neuralbertatech/natKit-IMU/(commit log)

2023-08-20 add new IMU library
2023-08-21 get new IMU working
2025-03-16 Starting point for board
    [Board.kicad_pcb, Board.kicad_sch, board.kicad_pcb, board.kicad_sch]
2026-04-09 Updated sample config
2026-07-27 IMU: frame envelope + heartbeat + reliable MQTT; restore real-sensor flow
    - NatImuBulkDataSchema carries a 24B binary frame header (schemaVersion,
    sampleCount, sampleRateHz, seqNo, deviceTsUs), populated per bulk; adds a
    ~1 Hz device.firmware.status.v1 heartbeat on a Heartbeat topic.
    - Restore real BNO08x streaming (regression fix): pin all lib_deps; the culprit
    was unpinned Adafruit BusIO floating to 1.17.3/1.17.4, whose SPIDevice rewrite
    crashed begin_SPI(). Pinned BusIO@1.17.2 + froze the tree.
    - Add -frtti (unflag -fno-rtti): the pinned libnatkit-core *Descriptor classes
    use dynamic_cast, which the espressif32 Arduino framework rejects by default.
    - MQTT robustness: KafkaTopic: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
    [kafkaTopic.hpp, main.cpp]
2026-07-27 IMU: disable status NeoPixels (RMT driver crash reboots the device)
    Adafruit_NeoPixel::show() re-installs the ESP32 RMT driver on every call and
    leaks channels; after ~11 calls rmt_driver_install asserts (xQueueGenericSend
    null queue) and the device reboots in a ~14 s loop. The cosmetic calibration /
    source-indicator LEDs are not worth crashing the stream, so gate them behind
    IMU_STATUS_LED_ENABLED (default 0). Re-enable in a later cleanup pass with the
    RMT driver installed once instead of per show().
    [ImuReader.hpp]
2026-07-27 IMU: fix heap leak that crashed the device with std::bad_alloc
    The intermittent reboot was an uncaught std::bad_alloc in NatImuBulkDataSchema::
    encodeToBytes when the heap ran out. Root cause: nat::core::Optional<T> (used by
    SensorDataPoint::dataMaybe) heap-allocates its value (new T) on every copy, and a
    SensorDataPoint is copied many times per IMU sample as it flows through the
    buffers — leaking/churning ~3 KB per bulk until allocation failed.
    Fix: store the value INLINE.
    - Add InlineOptional<T> (no heap, no C++17 dep — the Arduino build is gnu++11)
    as a drop-in for the .value()/.has_value()/`= T{}` subset used, and use it for
    SensorDataPoint::dataMaybe instead of nat::core::Optio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
    [SensorBuffer.hpp]
2026-07-27 IMU: use nat::core::Optional (now inline) for dataMaybe; drop InlineOptional
    libnatkit-core's Optional<T> now stores its value inline (no heap), so the
    firmware-local InlineOptional stopgap is no longer needed. SensorDataPoint::
    dataMaybe goes back to nat::core::Optional<T> and InlineOptional is deleted.
    Verified on hardware: 0 aborts over 60 s, ~2.4 sends/s, heap stable (the CircularBuffer
    512->32 right-size stays).
    Requires the matching libnatkit-core Optional change (inline storage).
    [SensorBuffer.hpp]
2026-07-27 IMU: bump libnatkit-core pin to 5f1e965 (inline Optional)
    a039fd0 -> 5f1e965: picks up the inline-storage Optional<T> (no per-copy heap
    alloc). Verified with a clean re-fetch + build + flash: 0 aborts, ~2.3 sends/s.
2026-07-27 IMU: drop dead deps — SensorLab (+~24-lib subtree), MQTT.h, ArduinoJson
    - Adafruit_SensorLab: unused member (never called) + include removed; dropping it
    from lib_deps drops its huge transitive Adafruit subtree. NeoPixel was pulled
    transitively by it and IS referenced (status LED, currently gated off), so it's
    now an explicit pinned dep.
    - 256dpi/MQTT (<MQTT.h>): unused (code uses PubSubClient); include + dep removed.
    - ArduinoJson: only-commented usages; dep removed.
    Flash 89.6% -> 88.6%. Verified on hardware: 0 aborts, ~2.1 sends/s.
2026-07-27 IMU: retry MQTT bring-up instead of stranding if broker is down at boot
    Previously, if MQTT couldn't connect within MQTT_MAX_CONNECT_RETRIES at boot, the
    firmware went to a dead Disconnected state and sat there until a manual reset. Now
    it backs off and re-enters the WiFi+MQTT bring-up from the top and keeps retrying
    (nothing is allocated before a successful connect, so retrying forever is safe).
    Verified on hardware: with the broker stopped the device loops connect→backoff→
    retry (no stranding); when the broker returns it reconnects and streams on its own
    with no reset (meta written, ~2.4 sends/s, 0 reboots).
    [main.cpp]
2026-07-27 IMU: drop -frtti; bump libnatkit-core pin to c1f0868 (getName dispatch)
    libnatkit-core no longer uses dynamic_cast (c1f0868 replaced it with getName()
    dispatch), so the firmware compiles with the Arduino framework's default
    -fno-rtti again. Removed the -frtti build_flag and the -fno-rtti build_unflag.
    Flash 88.6% -> 87.7%. Verified: builds + runs (0 aborts, streaming).
    Requires libnatkit-core c1f0868 to be pushed (pin points at it).
2026-07-27 IMU: fix warnings surfaced by the ESP-IDF build attempt (Phase 2a groundwork)
    The stricter ESP-IDF (arduino+espidf) build exposed real issues, fixed here (all
    valid under the current Arduino build too):
    - ImuReader start2(): printf("%s", std::string) -> .c_str() (was UB / would crash
    on the sensor-start error path).
    - ImuReader update_loop() debug stats: printf("%d", uint64_t) -> "%llu" + casts.
    - Bno08xDevice2: stray trailing '\' turned a // comment into a multi-line comment.
    - kafkaTopic ctor: member-init order now matches declaration order (metaStream
    before bulkDataStream) — was a -Wreorder.
    platformio.ini keeps framework=arduino; the arduino,espidf line is annotated with
    the rema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
    [Bno08xDevice2.hpp, ImuReader.hpp, kafkaTopic.hpp]
2026-07-27 IMU: remove vendored components/ (stock ESP-IDF 5.x copies, unused, blocked IDF build)
    components/esp_eth, esp_netif, esp_netif_stack were verbatim upstream ESP-IDF 5.x
    component copies (full with test_apps/, Kconfig, linker.lf) — not natKit code and
    not referenced anywhere. Under pure-Arduino they were ignored; under the ESP-IDF
    build they're processed as components and broke it (esp_eth REQUIRES esp_driver_spi,
    a 5.x-only component absent from the bundled 4.4.7). The IMU uses WiFi (framework's
    esp_netif), not Ethernet. Removing them clears the first Phase-2a (arduino,espidf)
    blocker; Arduino build unaffected.
2026-07-27 WIP Phase 2: ESP-IDF 5.x re-baseline via pioarduino (COMPILES; boot-blocked)
    Platform espressif32@6 (arduino 2.0.17 / IDF 4.4.7) -> pioarduino 55.03.311
    (arduino-esp32 3.3.11 / ESP-IDF 5.5.5, matches natVR). Builds clean after:
    - WiFiEvent(): SYSTEM_EVENT_* -> ARDUINO_EVENT_WIFI_* (arduino 3.x enum), simplified
    to the functional STA cases.
    - esp_task_wdt_init(timeout,panic) -> IDF 5.x config-struct + esp_task_wdt_reconfigure.
    - #include <esp_mac.h> for esp_efuse_mac_get_default (moved in IDF 5.x).
    - board_build.partitions = huge_app.csv (arduino 3.x overflows the default ~1.3MB app).
    - removed stale sdkconfig.release (was IDF 5.1.1).
    BLOCKED at boot: "esp_timer: Not enough memory to creat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
2026-07-27 Phase 2: ESP-IDF 5.x re-baseline BOOTS + streams on hardware
    pioarduino / arduino-esp32 3.3.11 / ESP-IDF 5.5.5 (matches natVR). Verified on the
    ESP32-PICO-D4: boots clean, BNO08x inits, WiFi + NTP + MQTT all up, streaming
    NatImuBulkDataSchema frames at ~2.5/s with zero crashes over 45s.
    Two boot-blockers fixed via `custom_sdkconfig` (triggers pioarduino's from-source
    Arduino/IDF HybridCompile instead of the PSRAM-board prebuilt libs):
    - CONFIG_SPIRAM=n / CONFIG_BT_ENABLED=n: the prebuilt esp32 libs assume a PSRAM
    board (SPIRAM=y, RESERVE_INTERNAL=0) and enable full BTDM (~64KB DRAM). The
    PICO-D4 has neither PSRAM nor a BT use, so the internal heap was starved and
    esp_timer couldn't cr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
    [huge_app.csv]
2026-07-27 IMU: gitignore pioarduino HybridCompile artifacts; drop stale espidf-experiment files
    custom_sdkconfig makes pioarduino build Arduino/IDF from source, which generates
    .dummy/, managed_components/ (dozens of IDF components), and sdkconfig.defaults/
    release in the project dir on every build — now gitignored. Also drop the leftover
    CMakeLists.txt / dependencies.lock / sdkconfig.debug from the abandoned Phase 2a
    combined-mode experiment (the build regenerates/removes them; a fresh CMakeLists
    will be written if/when subsystems go native ESP-IDF).
2026-07-27 IMU: natVR-style small frames for a smooth live stream (10 samples/frame)
    The stream was choppy/laggy in the viewer because the firmware batched a full
    IMU_POLLING_HZ (100) samples into one ~5 KB frame and only flushed it once full —
    ~2.6 frames/s, a big burst every ~380 ms. natVR stays smooth by flushing a small
    fixed frame the instant it fills (50 samples → ~20 fps) and draining it with a
    notify-driven publish. The IMU already had the notify-driven send; it just batched
    too much.
    Decouple the two meanings IMU_POLLING_HZ was overloading:
    - IMU_SAMPLES_PER_FRAME = 10 — the wire frame batch size (was 100). The BNO08x
    merged accel/gyro/rotation stream runs ~120-250 Hz, so 10 samples/f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
    [kafkaTopic.hpp]
2026-08-04 BNO08x: stop the boot crash loop (null write in sh2 sensor callback)
    Adafruit_BNO08x keeps a file-static sh2_SensorValue_t* that its SH2
    sensor callback writes through, and it is NULL until the first
    getSensorEvent() assigns it. Every sh2 op pumps SHTP while awaiting its
    reply, so once one report was enabled a queued sensor event was delivered
    mid-op and the callback wrote through NULL -- StoreProhibited at address
    0 inside sh2_decodeSensorEvent, on every boot.
    Prime the static with the long-lived member before enabling any report,
    configure calibration while the chip is still silent, and zero-init
    sensorValue (getSensorEvent decides "no new event" partly from sensorId,
    so garbage could fak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
    [Bno08xDevice2.hpp]
2026-08-05 Phase 1 cleanup: centralise config, delete dead code, fix stale comments
    Behaviour-preserving pass from the overhaul plan, after the fix-first work.
    - BoardConfig.hpp is now the one place for pins, the sample interval and the
    MQTT port. The BNO08x SPI pins were previously defined IDENTICALLY in both
    Bno08xDevice2.hpp and ImuReader.hpp: an identical macro redefinition is
    legal, which is exactly what made it dangerous -- edit one copy and the
    build stays silent while half the firmware talks to different pins. The
    hardcoded 1883 in main.cpp becomes NATKIT_MQTT_PORT.
    - Deleted 690 lines of commented-out code: the Kafka-REST/HTTP legacy in
    kafkaTopic.hpp (617 -> 315 lines) and old sa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
    [Bno08xDevice2.hpp, BoardConfig.hpp, ImuReader.hpp, kafkaTopic.hpp, main.cpp]
2026-08-05 BNO08x: stop sh2_setCalConfig failing silently, and log what the hub says
    Measured on hardware while investigating a report that calibration got worse:
    sh2_setCalConfig(0x07) FAILED with -5 (SH2_ERR_HUB)
    dynamic calibration enabled = 0x05 (accel=1 gyro=0 mag=1)
    Two separate findings.
    1. The call only succeeds as the FIRST hub command after begin_SPI. Asked any
    later -- after the priming getSensorEvent(), or after the enableReport calls --
    the hub rejects it. It has sat after the reports since Feb 2026 (71e3be8) with
    its return value discarded, so it had been failing silently that whole time.
    Moved to the front, where it succeeds.
    2. Even when it succeeds the hub repo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
    [Bno08xDevice2.hpp]
2026-08-05 BNO08x: record what the calibration probe established
    Removes the temporary probe loop and keeps its finding in a comment:
    sh2_getCalConfig is not a faithful read-back on this hub. Probed as the first
    hub command, every mask (0x01, 0x02, 0x04, 0x03, 0x05, 0x07, 0x0f) was accepted
    with a return of 0, while the read-back stayed 0x05 in every case -- including
    when only SH2_CAL_ACCEL was set.
    So the logged value reports what the hub says, not what is in effect, and it
    cannot be used to confirm gyro dynamic calibration is enabled. This also
    retracts the earlier note claiming the hub "drops SH2_CAL_GYRO": the read-back
    simply does not track the setting.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
2026-08-05 BNO08x: keep the streaming order; log the calibration probe findings
    Investigating a report that calibration quality regressed. Findings, all measured
    on hardware:
    - sh2_setCalConfig returns SH2_ERR_HUB (-5) where it sits, and has done since
    Feb 2026 (71e3be8) with its return value discarded, so it failed silently that
    whole time. That predates nothing: it was ADDED in Feb, so a year ago it was
    not called at all and the chip ran on its defaults -- as it still does.
    - Making it the first hub command DOES make it succeed. Do not do that: the
    BNO08x then stops producing sensor reports entirely ("Nothing to read" x120,
    zero frames published). Reverted to the ordering verified streamin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
    [Bno08xDevice2.hpp]
2026-08-05 Firmware: EXECUTION_COMMAND channel (server -> sensor) with output on LOGGING_LOG
    The device now subscribes to its own command topic and executes what the server
    sends, reporting the result on its log topic correlated by command_id:
    Kafka Command-<id>-Json-NatExecutionCommandV1
    -> bridge -> MQTT natKit/receiving/<topic> -> device
    -> MQTT natKit/sending/Log-<id>-Json-NatLogV1 -> bridge -> Kafka
    Commands: ping, calibrate.save_dcd, calibrate.status. "target" addresses either
    "sensor" (or this device's id) or "server", so the same topic can carry traffic
    in both directions; anything aimed elsewhere is ignored.
    PubSubClient is single-writer and the SH2 hub belongs to the IMU task, so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
2026-08-05 Firmware: actually enable gyro dynamic calibration (fixes rotation stuck at Unreliable)
    The BNO085's rotation accuracy has been pinned at Unreliable because gyro dynamic
    calibration was never on. sh2_setCalConfig has returned SH2_ERR_HUB from setup()
    since Feb 2026 (71e3be8, where its return value was discarded), leaving the hub
    on its documented default 0x05 = accel|mag. Gyro accuracy therefore sat at 0
    forever, and no amount of careful hand-calibration could move the rotation
    vector. That is the whole bug.
    The call cannot be made to work anywhere in setup(). Measured, on hardware:
    as the first hub command -> SH2_OK, but the hub then emits no reports at all.
    before the enableReports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
    [Bno08xDevice2.hpp, CommandChannel.hpp, ImuReader.hpp, main.cpp]
2026-08-05 Firmware: mask the SH2 status byte before treating it as an accuracy
    sensorValue.status is not an accuracy: bits 1:0 are the accuracy (0 = Unreliable
    .. 3 = High) and bits 7:2 carry the report delay. All eight read sites used it
    raw, and the values are later packed two bits per sensor -- so any report with a
    nonzero delay both misreported its own sensor and spilled into the neighbouring
    sensors' fields. Masked at the source, plus a packAccuracy() guard at the packing
    site so an out-of-range value can never corrupt a neighbour again.
    Latent until now (the delay bits have been zero in every frame measured), but it
    sits directly under the calibration readout, which is the thing being trusted.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
2026-08-06 Updateds to try to fix calibration issues
    [Bno08xDevice2.hpp, ImuReader.hpp, main.cpp]
2026-08-10 Scaffold the native ESP-IDF fork beside the current firmware (TEC-NATKIT-21)
    Slice 0 of the primary/secondary architecture epic (TEC-NATKIT-20): stand up
    the fork, decide where it lives, and write down the rollback contract before
    any behaviour is ported, so nothing later has to be untangled from the working
    image.
    firmware-idf/ is a sibling of embeded/, native idf.py, modelled on
    natVR/firmware. Nothing here edits embeded/, which stays the image on the
    bench; the two trees share no toolchain, no build directory and no config.
    The role (leaf / primary / gateway) is a Kconfig choice rather than a
    hand-edited define, so it is three images from one tree. main.cpp logs the boot
    banner -- firmw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
2026-08-10 Correct the esp32 defaults from what the board actually reports (TEC-NATKIT-21)
    Booting the leaf image on the real node (ESP32-PICO-V3-02, MAC
    0c:8b:95:96:b9:f4) contradicted two comments written from the datasheet:
    - The chip has 8 MB of embedded flash, not 4 MB, so the app warns on every boot
    that the detected size exceeds the image header. Left declared at 4 MB
    deliberately -- under-declaring wastes flash, while an image header claiming
    8 MB on a 4 MB part is the direction that breaks, and the older PICO-D4 in the
    fleet is a 4 MB part. Documented rather than silently "fixed".
    - The V3-02 does have embedded PSRAM. It stays off, but now for the real reason
    (nothing needs it, and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
2026-08-10 READMEs: record the hardware verification and the board's current firmware
    The fork's README claimed the boot was unverified; it is verified now, so say
    what was seen rather than leaving a stale caveat. Also record that the node
    briefly ran the leaf image and was restored, where the pre-flash flash dump
    lives, and the two console gotchas: read the serial port from exactly one
    process (two readers splice lines together and it reads like a firmware bug),
    and idf.py qemu needs a libslirp this box does not have.
2026-08-10 README: document the QEMU boot check, now that it works on this box
    libslirp landed, so idf_tools could install qemu-xtensa and qemu-riscv32, and
    every role can get a boot check with no board attached. All six images have now
    been booted rather than merely built: leaf/esp32 on the real node, and
    primary/esp32, gateway/esp32 and leaf/esp32c3 under QEMU -- the C3 reporting
    "rev 0.3, 1 core(s)" also confirms the packed-revision handling on a second
    target.
    Three caveats recorded, because each would otherwise cost someone an hour: the
    plain `qemu` action works headless while `qemu monitor` refuses without a TTY;
    QEMU's efuse is blank so the MAC and device id read zero and must not be
    "fixed"; a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
2026-08-11 BNO08x on native ESP-IDF: driver, SPI HAL and setup (TEC-NATKIT-22, WIP)
    NOT STREAMING YET. The sensor initialises, talks, and produces real readings,
    but sustained streaming stops after a handful of reports. Committed because the
    transport, the setup sequence and two hardware findings are worth not losing, and
    because the diagnostics below are what any further debugging needs.
    What is in:
    - components/sh2: Hillcrest/CEVA's SH-2 driver lifted verbatim out of the
    Adafruit BNO08x 1.2.5 copy the Arduino firmware links (Apache 2.0, unedited).
    Identical decode is the point -- it is what makes a recording from the fork
    comparable with one from ../embeded, which is what TEC-NATKIT-27 measur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
2026-08-11 ESP-NOW bench probe: the frame fits in one packet (TEC-NATKIT-23)
    The epic sized the on-air frame problem from a "~5 KB frame" against ESP-NOW's
    "250 byte" limit. Both numbers were wrong, and the difference removes the
    fragmentation question entirely.
    Measured, not assumed:
    - The frame is 524 bytes. NatImuBulkDataSchema Binary encodes 24 + 50 *
    sampleCount and the running firmware publishes 10 samples per frame -- the live
    console prints "Bytes Encoded 524". The 5 KB figure looks like the legacy
    5000-byte fallback or the 16 KB MQTT buffer, not what is transmitted.
    - ESP-NOW on this PICO-D4 reports version 2 with a ceiling of exactly 1470 bytes:
    1470 is accepted and confirmed, 1471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
    [espnow_probe.cpp, espnow_probe.hpp, main.cpp]
2026-08-12 Un-gate the ESP-NOW channel so the node roles build again (TEC-NATKIT-23)
    CONFIG_NATKIT_ESPNOW_CHANNEL depended on NATKIT_ESPNOW_PROBE, so the symbol
    disappeared whenever the probe was not selected -- and espnow_probe.cpp, which
    compiles into EVERY image by design, reads it as a value. Leaf, primary and
    gateway therefore all failed with "'CONFIG_NATKIT_ESPNOW_CHANNEL' was not
    declared in this scope" since e7894ca. Only the probe role built.
    The dependency is dropped rather than wrapping the file in #if
    CONFIG_NATKIT_ESPNOW_PROBE, because compiling every source into every image is
    the invariant that stops a role from silently rotting; making the probe
    conditional would exempt it from exactly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
2026-08-12 BNO08x streams on native IDF: drive MOSI, drive CS by hand (TEC-NATKIT-22)
    The port read the hub correctly but could not sustain streaming: a few reports
    arrived, then the hub reset itself ~10 times in 40s and reads returned 15-byte
    SHTP channel-0 packets instead of the channel-3 sensor reports that had been
    enabled. Two differences from ../../embeded's Adafruit stack -- which streams on
    this exact board -- were found by reading it rather than by guessing, and fixing
    both is what makes the difference.
    MOSI was not driven at all. Adafruit_SPIDevice::read() memsets the caller's
    buffer to its sendvalue (0x00 here) and then does a FULL-DUPLEX transfer, so
    MOSI carries zeros for every clock of e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
    [bno08x.cpp, leaf.cpp]
2026-08-12 ESP-NOW loss run: fix the instrument, then measure zero loss (TEC-NATKIT-23)
    The multi-node loss run needed a second board, which arrived. Running it found
    three defects in the probe first, all of which corrupted the very figure the
    receiver exists to produce -- it reported 3051 sequence gaps from 243 packets,
    which would have read as catastrophic loss.
    The sequence is now ONE monotonic counter for the whole probe run, advanced only
    when esp_now_send accepts the frame:
    - measureSendRate used the loop index, so each run restarted at 0 and the runs
    could not be told apart on the receiving side.
    - That index advanced even when esp_now_send REJECTED the frame. Flat out, 340 of
    500 are refus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
    [espnow_probe.cpp]
2026-08-12 Leaf: sensor to ESP-NOW, no WiFi, no MQTT, no NTP, no netif (TEC-NATKIT-24)
    The leaf role is real. It builds the canonical NatImuBulkDataSchema frame on the
    node -- TEC-NATKIT-23's recorded decision -- and unicasts it to a primary it
    discovers, with a bounded queue between the sample loop and the radio.
    new imu_frame.{hpp,cpp}: the canonical frame encoder. This is deliberately a
    SECOND implementation of a wire format that lives in libnatkit-core, because a
    leaf that links a C++ schema library is not the lean node this epic is testing.
    That duplication can drift, so the layout is pinned by static_asserts on every
    size (including that 10 samples encode to exactly 524 bytes), derived from the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
    [espnow_link.cpp, espnow_link.hpp, imu_frame.cpp, imu_frame.hpp, leaf.cpp, primary.cpp]
2026-08-12 Timing broadcast and time-shift proxy: nodes on one clock (TEC-NATKIT-17)
    Leaves have no NTP by design, so their sample timestamps are monotonic since
    their own boot and two nodes' timestamps are not comparable. The primary is now
    the clock master and closes that gap.
    The ticket's first recommended approach does not survive the architecture, and
    this was checked before any code was written: esp_wifi_get_tsf_time() returns 0
    on a station that is not associated, and no node here ever associates. Confirmed
    on hardware, not just cited from the header. Its receive-side counterpart does
    exist -- rx_ctrl->timestamp is a genuine hardware stamp -- but measured against
    esp_timer it scatters by 20-57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
2026-08-12 Node-to-node coherence, measured against a held-out marker (TEC-NATKIT-4)
    #340 measured each leaf against the primary. What a recording with two sensors on
    it actually depends on is whether two LEAVES agree, and that was only inferred --
    from two leaf-to-primary figures plus an argument that their common-mode bias
    cancels. Reasonable, and untested. With a third board it is now measured.
    The primary broadcasts a SyncMarker every fifth beacon. Both leaves receive the
    same wavefront -- they are metres apart, so propagation between them differs by
    nanoseconds -- each converts its own receive time into primary time with its own
    fit, and reports the answer. The difference between the two answers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
2026-08-12 Primary: node registry, framed serial uplink and explicit backpressure (TEC-NATKIT-25)
    Two leaves now stream through one primary to a host reading framed serial, with
    counters that reconcile.
    REASSEMBLY IS OUT, and this is a deletion rather than a deferral. The ticket says
    "rebuilds whole frames IF the frame-format decision puts reassembly here", and
    #346 decided it does not: 524 bytes against a measured 1470-byte ESP-NOW ceiling,
    one frame is one packet. So there is no fragment buffer to time out, and a lost
    packet stays a whole missing frame that seqNo makes detectable.
    The frame carries TWO sequence numbers, which is the point of its header. The
    uplink's own says whether the primary dro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
    [espnow_link.cpp, primary.cpp, read_uplink.py, registry.cpp, registry.hpp, uplink.cpp, uplink.hpp]
2026-08-12 Gateway: serial in, WiFi and MQTT out, real timestamps (TEC-NATKIT-26)
    A leaf's data now reaches Kafka through primary, serial, gateway, MQTT and the
    bridge, on the topic the bridge and backend already expect, with no server-side
    change.
    THIS IS WHERE THE CHAIN OF CUSTODY FOR TIME ENDS, and three slices built toward
    it: leaf device time -> primary time (the leaf's own fit, #340) -> wall clock
    (here, the only device with NTP). Doing it in that order is what kept the
    correction undoable -- raw device time is still on the wire at every hop before
    this one. The gateway patches the canonical frame's timestamps IN PLACE rather
    than decoding and re-encoding, because a round trip would be a third
    i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
    [gateway.cpp, gateway_net.cpp, gateway_net.hpp, uplink_reader.cpp, uplink_reader.hpp]
2026-08-12 Gateway: stop batching the stream -- power save off, short reader timeout
    Zach reported the live view was choppier than with the current firmware and
    guessed radio multiplexing. It was not: no chip multiplexes, and the leaf and
    primary measure clean. It was two compounding defects in the gateway, both
    introduced in cea0421.
    1. The gateway never disabled WiFi power save, so it defaulted to
    WIFI_PS_MIN_MODEM and slept between the AP's beacons. Publishes queued and
    went out in bursts at beacon boundaries. The leaf and primary already set
    WIFI_PS_NONE for #340's timing work; the gateway needs it for a plainer
    reason -- it is always on and its whole job is forwarding promptly.
    2. The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
    [gateway_net.cpp, uplink_reader.cpp]
2026-08-13 Primary WiFi uplink: one chip doing both radios, and what it costs (TEC-NATKIT-30)
    The stopgap #373 was filed for, built to answer the question it was filed to
    answer: do we actually need two ESP32s? Kconfig NATKIT_PRIMARY_WIFI_UPLINK makes
    the primary associate with an access point and publish straight to the broker
    while remaining the ESP-NOW hub and timing master. No serial link, no gateway.
    Two structural changes were needed before it could work at all, and both are
    about the channel:
    1. AN ASSOCIATED STATION DOES NOT CHOOSE ITS CHANNEL. Measured: this AP is on
    channel 11, so associating drags the hub off the configured channel 1. The
    primary therefore stops calling esp_wifi_set_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
    [espnow_link.cpp, espnow_link.hpp, gateway.cpp, gateway_net.cpp, gateway_net.hpp, primary.cpp, time_sync.cpp, time_sync.hpp]
2026-08-13 Add the ESP32-S3 target, for the Ethernet route (TEC-NATKIT-26 / #373)
    Zach replaced one node with an ESP32-S3 carrying an Ethernet daughterboard, which
    is a better answer than either of the two architectures measured so far: Ethernet
    is OFF THE RADIO ENTIRELY, so ESP-NOW keeps a channel we choose on a radio nobody
    else is using, with no second chip bridged over serial. #373 measured the WiFi
    alternative losing ~85% of ESP-NOW frames because an associated station takes the
    AP's channel and its WiFi task starves the receive path.
    The board: ESP32-S3 rev 0.2, 2 cores, 2 MB embedded PSRAM, MAC b8:f8:62:62:f7:3c,
    device id 203376942053180. It boots as an ESP-NOW primary and timing master, heap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
    [main.cpp, uplink.cpp, uplink_reader.cpp]
2026-08-13 Ethernet uplink on the ESP32-S3: it works, and the board's radio does not
    The wired route Zach asked for: one chip running the ESP-NOW hub, the timing
    master and a WIRED uplink, with no radio contention -- the thing #373 could not
    achieve over WiFi. New ethernet_net.{hpp,cpp} drives the W5500; the SNTP, MQTT
    and timestamp-rewrite halves are reused unchanged, because splitting
    gatewayWifiStart from gatewayServicesStart on TEC-NATKIT-26 left them
    netif-agnostic.
    Measured on the ESP Thread Border Router board: W5500 link up 2.3 s after boot,
    DHCP address at 3.3 s, ESP-NOW primary on channel 1 -- OUR channel, since there
    is no association to inherit one from -- and no panic.
    ⚠️ EVERY PIN A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
2026-08-13 Channel 1 was jamming the S3, not its antenna: 66 dB from moving to 11
    The wired one-chip architecture works. It looked like a dead receiver for most of
    a session, and it was interference on a single channel.
    THE MEASUREMENT. Same two boards, a few centimetres apart, nothing changed but
    the ESP-NOW channel:
    channel 1 channel 11
    rssi -82 dBm -16 dBm
    data frames 4-8 285 at the full 5/s
    sequence gaps hundreds 12
    WHY IT LOOKED LIKE HARDWARE, and why that reasoning was wrong. The symptom was
    asymmetric: the leaves heard the hub at -25 dBm while the hub heard them at -82.
    An antenna cannot do that -- a passive RF path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
    [espnow_link.cpp, espnow_link.hpp, leaf.cpp]
2026-08-13 Count the frames the publish path was discarding silently
    Zach saw 1.7-4.7 frames/s in the frontend against a radio delivering 5/s with
    ZERO sequence gaps, and every counter on the device said it was healthy. The
    frames were being dropped between reception and the uplink queue, in a branch
    that simply did nothing when its preconditions were not met -- no counter, no
    log, no way to see it. That is the fourth time this epic has been misled by a
    counter that did not count what mattered, and the first where the answer was that
    no counter existed at all.
    Three causes now counted separately, because they have different fixes:
    publish_no_sync the leaf's fit had not arrived yet
    publish_no_ti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
    [espnow_link.cpp, espnow_link.hpp, primary.cpp]
2026-08-13 Sample at 100 Hz, and drop duplicate frames (TEC-NATKIT-35, partial)
    The frame header has always declared sampleRateHz = 100 while the sample loop ran
    at 50, in BOTH firmwares: embeded's DELAY_BETWEEN_SAMPLES is 20000 us against its
    own IMU_SAMPLE_RATE_HZ of 100, and the fork copied both as "compatibility"
    settings -- which was preserving a bug rather than matching a peer.
    So the sample interval goes 20000 -> 10000 us, and the hub's report interval
    18000 -> 10000 with it: sampling at 100 Hz while asking the sensor for reports at
    55 Hz would just duplicate values, which is the same lie in a new place.
    AT THE SOURCE THIS WORKS. The hub honours it -- 412 reports/s across the four
    enabled repo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
    [espnow_link.cpp]
2026-08-13 Deliver 100 Hz: publish before dedupe, and a drifting sample deadline
    Two bugs between "the sensor produces 100 Hz" and "the broker receives it".
    Delivered sample rate, measured by decoding frames off the broker and counting
    DISTINCT seqNo:
    50 Hz baseline ~42 samples/s
    after the 100 Hz change 30 samples/s (a regression)
    after the dedupe fix 78 samples/s
    after the deadline fix 92 samples/s
    1. THE DEDUPE ADDED IN THE LAST COMMIT WAS DECORATIVE. The sequence-tracking
    block sat AFTER the shift-and-publish call, so the `return` that was supposed
    to drop a duplicate fired once the frame had already gone to MQTT. It stopped
    last_seq advancing and nothing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
    [espnow_link.cpp, leaf.cpp]
2026-08-13 Sample in its own task: 101 samples/s reaches Kafka (TEC-NATKIT-35)
    The target, measured at the real consumer -- 305 records in 30 s on the Kafka
    topic the backend reads, so 10.1 frames/s of 10 samples.
    100 Hz, first attempt 30
    after the dedupe fix 78
    after the deadline fix 92
    after this 101 samples/s
    THE DOMINANT LOSS WAS THE LEAF'S SAMPLE LOOP, not the radio and not the network.
    Sampling shared a loop with imu.service(), and a service() call that overran the
    deadline cost a sample outright. At the old 20 ms interval that was invisible; at
    10 ms it was MEASURED AT 15.2% -- 592 slots of 3903 -- while the primary rep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
    [leaf.cpp]
2026-08-13 Rescan on beacon silence, not on send failures (TEC-NATKIT-35)
    A leaf was abandoning a primary it was successfully feeding. Basing the decision
    on consecutive send failures was wrong: a "failure" means no MAC-layer ACK came
    back, and on this rig that happens constantly WHILE THE FRAMES ARRIVE -- measured
    at 399 tx failures against a hub receiving ~10 frames/s and forwarding them to
    Kafka. So the leaf kept giving up its channel and spending as long as 17 seconds
    hopping, which is what made the frontend swing between 3 and 11 frames/s.
    Beacon silence is the authoritative signal instead. The primary broadcasts every
    second and broadcasts need no ACK, so hearing them proves the hub is present a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
    [espnow_link.cpp]
2026-08-13 Log whether frames arrive unicast or broadcast, and kill a wrong theory
    I suspected delivery was riding a broadcast fallback: a leaf that gives up on
    unicast sends to the broadcast address, which needs no acknowledgement and
    therefore always "succeeds", so a rig running entirely on that path would look
    healthy while the designed one was broken. des_addr in esp_now_recv_info_t is the
    only place the distinction survives, since ESP-NOW hands both to one callback.
    MEASURED: 49 unicast, 0 broadcast. The theory was wrong and is now cheap to
    re-check rather than argue about.
    What the same session then found instead, with one leaf powered down as Zach
    asked: the REMAINING leaf (0c:8b:95:96:bc:4c)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
    [espnow_link.cpp, espnow_link.hpp, primary.cpp]
2026-08-13 Stop the leaf busy-spinning, and move ESP-NOW off the AP's channel
    TWO REAL FAULTS, one of them mine from three commits ago.
    1. THE LEAF'S MAIN LOOP WAS A BUSY SPIN. When sampling moved to its own task, the
    loop kept a deadline-aware delay that computed its wait from `next_sample_us`
    -- which nothing advances any more. `remaining` was therefore always 0, so it
    called imu.service() as fast as the CPU allowed, hammering SPI continuously.
    Cost: 81% OF RECEIVED BEACONS, at -22 dBm, so it read as a radio problem and
    was not one. Removing it took beacon loss from 81% to 10%. Sampling no longer
    depends on this loop's timing, so a plain tick is correct.
    2. ESP-NOW WAS ON THE HOUS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
    [leaf.cpp]
2026-08-13 Channel 3, chosen by sweeping against a site survey (TEC-NATKIT-35)
    Zach's UniFi scan showed two strong access-point clusters centred on 6 and 11,
    with only a weak wide signal across 1-5. That immediately condemned the previous
    choice: this firmware had just been moved to channel 6, which is one of the two
    busiest parts of the band on this site.
    Rather than pick from the chart, the hub's own view of a leaf was swept:
    channel hub hears leaf delivered
    3 -22 dBm 10 frames/s <- the full rate
    6 -21 .. -57 dBm varies
    9 -61 dBm 0
    11 -83 dBm 0
    13 nothing 0
    1 -82 dBm jammed by the Thread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
2026-08-13 Survey the band at boot and pick the channel (Zach's idea)
    The primary cannot publish for the first ~33 s after a reset anyway -- NTP has not
    synced, so every data frame is refused rather than published with a 1970
    timestamp. Zach's suggestion was to spend that dead time surveying, and thirteen
    channels at 2 s each is 26 s, which fits with room to spare.
    Worth doing because channel choice has been the single largest factor in this
    rig's throughput and it is a property of the SITE, not the firmware. On one bench
    the hub's view of a leaf a few centimetres away ranged from -22 dBm and the full
    rate to -83 dBm and nothing at all, purely by channel. A hard-coded number that is
    right in one room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
    [channel_survey.cpp, channel_survey.hpp, espnow_link.cpp]
2026-08-13 Survey off by default: it measures the wrong thing, and can kill the link
    THREE FINDINGS, and the first two are mine.
    1. THE SURVEY DID NOT OVERLAP THE NTP WINDOW, IT QUEUED IN FRONT OF IT. The whole
    point was to spend the ~33 s in which nothing can be published. Started after
    the radio, it pushed first publish from ~33 s to ~60 s. SNTP and MQTT are
    netif-agnostic and the Ethernet link is already up by then, so they now start
    BEFORE the radio: measured survey 0.4-26.4 s, clock synced 32.5 s. Genuinely
    free now.
    2. THE SURVEY SCORES THE WRONG SIGNAL, so it is now DEFAULT OFF. It measures
    other networks' 802.11 traffic, which is not what limits this rig -- the
    interferen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
    [primary.cpp]
2026-08-13 FULL POWER WAS THE BUG: the receivers were overloaded, not deaf
    Turning both radios DOWN from 19.5 dBm to 2 dBm took the hub from 0.4 received
    frames/s to 8.5, and end-to-end delivery from nothing to 96 samples/s. That is a
    20x improvement from transmitting less, which is the opposite of the intuition
    and is why it took so long to consider.
    THE PHYSICS, which fits every symptom that has been confusing this rig. At the
    IDF default of 19.5-20 dBm and a few centimetres of separation, free-space loss is
    only about 10 dB, so the signal arriving at the other board is around +9 dBm.
    That is far above any 2.4 GHz receiver's linear range: the front end compresses,
    the AGC mis-reports, and packets ar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
    [espnow_link.cpp, uplink.cpp]
2026-08-13 Leaf sweeps its transmit power at startup and keeps the lowest that works
    Zach's suggestion, after turning the radios down by hand took delivery from
    nothing to 96 samples/s. The leaf now finds the setting itself: 97 samples/s with
    no hand-set power, and it will find a different answer at a different spacing
    rather than needing one.
    2.0 dBm: 22 acked of 22 (100%) <- chosen
    5.0 dBm: 18 acked of 18 (100%)
    8.5 dBm: 23 acked of 23 (100%)
    11.0 dBm: 19 acked of 19 (100%)
    14.0 dBm: 22 acked of 22 (100%)
    17.0 dBm: 19 acked of 19 (100%)
    19.5 dBm: 22 acked of 22 (100%)
    Unlike NATKIT_CHANNEL_SURVEY -- which scores strangers' 802.11 traffic and had to
    be defaulted off after i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
2026-08-13 Pick transmit power by best ack rate, not a threshold that never passed
    The sweep had an acceptance bar of 90% acked and has never once cleared it.
    The measured table on this bench is 2.0 dBm at 13% and every higher level at
    0%, so on every boot it fell through to its fallback -- and went unnoticed
    because that fallback was the floor, which is also the correct answer here. It
    looked like a working sweep because it agreed with a working answer.
    What exposed it was trying to fix something else. Two leaves running together
    showed a near-far problem: the closer one arrived 15-25 dB stronger and captured
    the hub, and the far one delivered 0.3 frames/s against the near one's 10.6
    while reporting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
    [espnow_link.cpp]
2026-08-13 Measure each IMU report separately; none of them runs at 100 Hz
    The leaf reported one aggregate "reports @ 391 Hz" figure, which cannot tell four
    reports at 100 Hz from three at 133 and one dead. Broken out per report, and the
    answer is that nothing runs at the configured rate:
    accel 117 Hz | gyro 95 Hz | mag 91 Hz | quat 95 Hz (100 Hz requested)
    The accelerometer takes a fifth more than it asked for and the other three go
    short. Against a 100 Hz sampler that means ~5% of samples carry the previous
    gyro and quaternion value, and ~9% the previous magnetometer value.
    Asking for more inverts it rather than fixing it. Uniform requests, delivered:
    request accel gyro mag quat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
    [bno08x.cpp, board_config.hpp, leaf.cpp]
2026-08-14 Put the magnetometer on the wire: frame version 2
    The magnetometer has been enabled and arriving at ~91 Hz the whole time, costing
    ~2 Hz of the other reports to keep running. It was missing from recordings only
    because the frame had no field for it.
    Thirteen floats instead of ten, so a sample is 62 bytes and a 10-sample frame 644
    instead of 524 -- still far below the 1470-byte ESP-NOW ceiling TEC-NATKIT-23
    measured, so a frame is still one packet and loss still degrades to whole missing
    frames. accuracies bits 7-6 and has_data bit 3 were already spare.
    The leaf only ever writes the current version; libnatkit-core is what reads both,
    which is what keeps every pre-2026-08 recording decodable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
    [ImuData.hpp, ImuReader.hpp, espnow_probe.cpp, imu_frame.cpp, imu_frame.hpp, kafkaTopic.hpp, read_uplink.py]
2026-08-14 README: the ESP-IDF fork is what the rig runs, not embeded/
    The table said embeded/ was "the firmware in use" and called firmware-idf a
    "scaffold: roles stubbed", last recorded 2026-08-10. Both leaves and the S3
    primary have been running firmware-idf images since 2026-08-12 -- including board
    0c:8b:95:96:b9:f4, which the board table specifically claimed was on embeded/.
    That file opens by saying knowing which firmware is on a board is not optional, so
    a wrong answer there is worse than no answer. Corrected, with ports and MACs for
    all three boards.
    Also flagged what is now true and was not before: the two firmwares are no longer
    wire-compatible by default. firmware-idf emits frame version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
2026-08-14 README: new firmware work goes in firmware-idf/, and one thing never made it across
    Zach's call: embeded/ is a rollback path, so leave it alone unless a change really
    needs it -- an edit there cannot be verified, since no board runs it, and it
    builds against a pinned GitHub commit rather than the sibling submodule, so it can
    go green while doing nothing.
    Also recorded the hazard in the other direction, which is not a preference: the
    EXECUTION_COMMAND channel exists only in embeded/ and was verified on hardware a
    week before the migration. Nothing errors when it is missing -- the backend half
    still publishes and the command goes unsubscribed (TEC-NATKIT-39).
2026-08-14 Per-report intervals, and the measured limits of what the hub will deliver
    Each report gets its own Kconfig interval, 0 = disabled, replacing one shared
    number that could not express what the hardware needs. tools/sweep_report_rates.sh
    builds, flashes and measures a list of configurations so the tables below can be
    reproduced rather than believed.
    The question was whether a full 100 Hz is reachable on every report, including by
    giving one up. Answers, all measured:
    ⚠️ THE 95 Hz SHORTFALL AT A 100 Hz REQUEST IS NOT CONTENTION. There is a ceiling
    near 475 reports/s, but four reports at 100 Hz only asks for 400, and freeing
    budget does almost nothing -- dropping a whole report returns 1-2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
    [bno08x.cpp, leaf.cpp]
2026-08-14 has_data becomes per-sample freshness, and that exposes an 88 Hz burst cadence
    Zach's call: has_data should say whether there was actually something to report
    for this sample, not whether the sensor has ever spoken. It was sticky -- true
    from a sensor's first report until reboot -- so it was true on essentially every
    sample and carried no information.
    Folded into frame version 2 rather than a version 3, because v2 has never been on
    trunk and nothing has been recorded with it. v1 keeps the sticky meaning; a
    consumer that needs to tell them apart has the frame version.
    Freshness is computed by COMPARING COUNTERS, not by setting and clearing a flag.
    Reports are applied on the service task whi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
    [bno08x.cpp, imu_frame.cpp, imu_frame.hpp, leaf.cpp]
2026-08-14 Command relay: server -> primary -> leaf, and the answer back
    Slice 1 of TEC-NATKIT-40, and the capability TEC-NATKIT-39 lost in the migration.
    The backend and the Visual Programming buttons were never touched by the move to
    ESP-IDF and are still correct; only the device half was missing, because a leaf in
    this architecture has no IP at all.
    ⚠️ THE LEAF NEVER SEES JSON. The primary parses the command document and relays a
    fixed-size POD over ESP-NOW. A leaf is a sensor and a radio, and linking a JSON
    parser into it to read a field it could have been handed is exactly the weight
    this fork exists to avoid. It also means a malformed command is rejected where
    there is a console and a broker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
    [command_relay.cpp, command_relay.hpp, commands.cpp, commands.hpp, espnow_link.cpp, espnow_link.hpp, gateway.cpp, gateway_net.cpp]
2026-08-14 Require an acknowledgement before a command counts as delivered
    Zach's point: with a bridge in the path and nodes that are not expected to be
    always on, "the radio accepted the packet" is not delivery. esp_now_send returning
    ESP_OK means it was queued, and a command for a sleeping or out-of-range node was
    being reported as relayed and then simply never happening.
    So a command is now held until the device acknowledges it, retransmitted every
    400 ms up to six times, and explicitly FAILED if it never is. `relayed` and
    `delivered` are separate counters and the second is the one that means anything.
    ⚠️ THE ACKNOWLEDGEMENT IS NOT THE ANSWER, and separating them is the point. An ack
    is sent t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
    [command_relay.cpp, command_relay.hpp, commands.cpp, commands.hpp, espnow_link.cpp, espnow_link.hpp, primary.cpp, uplink.hpp]
2026-08-14 Runtime report configuration, and a panic the reset-reason counter caught
    Slices 2 and 3 of TEC-NATKIT-40: an NVS-backed report mask on the leaf, plus
    get_reports and set_reports over the command channel.
    Kconfig still sets each report's RATE; the runtime mask decides which are on. The
    mask bits are deliberately the SAME bits has_data uses on the wire -- accel 0b100,
    gyro 0b010, rotation 0b001, magnetometer 0b1000 -- so a configuration and a
    sample's presence byte can be compared without translating either.
    ⚠️ DISABLING CLEARS THE SENSOR'S READING. The frame builder copies each sensor's
    last value into every sample and marks freshness separately, so without this a
    switched-off sensor w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
    [bno08x.cpp, bno08x.hpp, command_relay.cpp, commands.cpp, commands.hpp, leaf.cpp]
2026-08-14 Persistence does work; the failure message was the thing that was wrong
    The previous commit said the report mask did not survive a reboot. That was
    wrong, and how it was wrong matters more than the fact.
    Making loadReportMask log every outcome rather than returning quietly showed
    "restored report mask 0x0f from NVS" -- it had been restoring correctly all along.
    0x0f is all four reports on, so the stored value had simply been changed back:
    by an earlier set_reports of my own whose ANSWER was lost, which I read as the
    command not having happened.
    Verified properly this time, with a value that could not be a default: set
    accel+gyro only (0x06), reboot, and the boot log says "restored report m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
    [bno08x.cpp, command_relay.cpp, espnow_link.hpp]
2026-08-14 Emit "terminal", not "final": every command was reporting a false timeout
    The backend's correlation loop waits for a log record whose "terminal" field is
    true, and the Arduino firmware has always sent that. This firmware invented
    "final" instead, so no record ever ended the wait: every command ran the full
    timeout and came back timed_out=true, ok=false, WHILE CARRYING the device's
    perfectly good answer in its records array.
    That is the worst shape a bug can take -- it looks exactly like a dead or
    unreachable device, which is a thing that genuinely happens on this rig several
    times an hour, so it would have been attributed to the radio indefinitely.
    ⚠️ AND IT WAS INVISIBLE TO EVERY TEST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
    [espnow_link.cpp]
2026-08-14 Every sample now carries all four sensors, fresh. The 88 Hz ceiling was ours.
    ⚠️ THIS RETRACTS THE CENTRAL FINDING OF THE LAST SEVERAL COMMITS. There is no
    ~88 Hz burst cadence in the BNO08x, no ~475 reports/s transport ceiling at the
    rates we were asking for, and no reason you cannot have all four reports at
    100 Hz. The hub emits evenly and delivers what it is asked for. We were not
    listening often enough, and every number that said otherwise was measuring our own
    firmware.
    The mechanism, and it is embarrassing in a useful way: sampling was moved to its
    own task a while back because imu.service() overrunning cost 15% of sample slots.
    But imu.service() ITSELF stayed on the main loop --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
2026-08-14 Publish the hub's per-node RSSI, and find that the near-far problem is gone
    The primary has always tracked how strongly it hears each node and has never
    published it, so the only per-node signal leaving the rig was a frame count. A
    node delivering nothing at -26 dBm and one delivering nothing at -85 dBm need
    completely different fixes, and the frame count cannot tell them apart -- which is
    why diagnosing this meant reading a console that resets the board it prints on.
    Now in UplinkNodeStatus, in its reserved bytes so the struct's size does not move.
    ⚠️ AND THE FIRST THING IT SHOWS IS THAT TEC-NATKIT-37's PREMISE NO LONGER HOLDS.
    Both leaves are heard at -26 and -27 dBm, both deliver 10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
    [primary.cpp, uplink.hpp]
2026-08-14 The 33-second stall was the leaf disabling its own retries
    Zach reported the frontend freezing for about a second every ~32 s, very
    consistently. It was 2.1 s every 33.0 s, machine-precise, and it was self-inflicted.
    A leaf presumed the primary gone after five consecutive on-air failures and then
    sent each frame ONCE with no retries. The reasoning in the comment was "five at
    5 frames/s is a second of silence" -- but this rig sends 10 frames/s plus
    heartbeats and probes, so five failures is a fraction of a second, and worse, an
    "on-air failure" here means no MAC-layer ACK came back, WHICH HAPPENS CONSTANTLY
    WHILE THE FRAMES ARRIVE. This codebase already measured that: 399 tx failures
    against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
    [espnow_link.cpp, espnow_link.hpp, leaf.cpp, primary.cpp, uplink.hpp]
2026-08-14 The 33-second stall was an unsigned underflow in the clock fit's ring buffer
    Zach's 32-second freeze. It is one missing cast.
    refit() takes sWindow[0] as the origin for its least squares. sWindow is a RING
    BUFFER, so while it is filling sWindow[0] is the oldest sample and every
    difference is positive. The moment it wraps -- at exactly kSyncWindow samples,
    which at one beacon a second is 32 seconds -- sWindow[0] is overwritten with the
    NEWEST sample and every other entry is older than the origin.
    Those differences were computed in uint64. Instead of going negative they
    underflowed to about 1.8e19, which destroyed the slope, which tripped the
    implausible-skew guard, which reset the window.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
    [primary.cpp, time_sync.cpp, uplink.hpp]
2026-08-17 Forward version 1 frames again: the rewrite assumed the compile-time sample size
    rewriteFrameTimestamps used kSampleSize to find each sample in the frame. The moment
    frame version 2 made that 62, every version 1 frame -- 524 bytes for ten samples --
    failed its length check and was refused, and the primary SILENTLY DROPPED it into
    publish_no_shift.
    So a node running older firmware looked like it was transmitting nothing at all,
    while the hub was receiving every frame it sent. Found when Zach swapped a leaf for a
    board that had not been reflashed: 29 frames received, 28 dropped, no Data topic for
    it, and nothing anywhere saying why.
    The sample size now comes from the frame's own schemaVersio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
    [time_sync.cpp]
2026-08-17 README: the board table moved with the swap, and the primary is ttyACM0 now
    Swapping a leaf reassigned every port. The table said the primary was ttyACM2 and
    two flashes were aimed there before that was noticed; esptool refused them ('This
    chip is ESP32, not ESP32-S3') rather than bricking a leaf, which is the only reason
    it cost minutes rather than a board.
    Records how to identify a port without touching the board -- the S3 reports its MAC
    as its USB serial number, so it is unambiguous, while the two CH340 leaves are not
    distinguishable from the descriptors alone. Also notes that the removed board is
    still in the primary's NVS registry.
2026-08-17 Give each node its own MQTT client id; two of them could never coexist
    All three connect() calls passed the literal "natKit-IMU". MQTT requires a broker
    to evict the existing session when a second client presents an id that is already
    connected, so two natKit-IMU nodes on one broker do not share it -- they take
    turns kicking each other off, and every frame built while a node is between
    sessions is dropped with seqNo advancing over it and nothing counting it.
    Measured for TEC-NATKIT-27, two nodes, 300 s, quiet build:
    before 699 "already connected, closing old connection" per 60 s
    23.7 frames/s built, 13.8 delivered -- 41% lost
    after 0 evictions, 24.7 built, 25.0 delivere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
    [kafkaTopic.hpp, main.cpp]
2026-08-17 README: the leaves' USB serials are distinct, and a reset leaf needs minutes
    Two facts this bench needed and the README denied. The CH340 leaves were said to be
    distinguishable only by flashing one and seeing which device id went quiet -- their
    ID_SERIAL_SHORT values are in fact stable and distinct, so the board/port/device-id
    mapping is now written down.
    And a leaf that has been reset publishes again in 18.7 s but is not at full rate for
    about ten minutes. Two single-node measurements were taken inside that window and
    read as faults before it was recognised.
    TEC-NATKIT-27.
2026-08-17 Give the app 3 MB instead of 1; the primary was at 93% of its partition
    TEC-NATKIT-49. All three roles were on ESP-IDF's stock single-factory table, which
    gives the app 1 MB, while every target declares a 4 MB flash. Measured 2026-08-17:
    leaf 709,312 B 67.6% -> 22.6%
    gateway 903,408 B 86.2% -> 28.7%
    primary 976,848 B 93.2% -> 31.0%
    So the tree that uses half the flash of embeded/ was the one about to hit a wall,
    and the primary is the role that keeps growing -- it took the command relay, the
    status frames, the coherence metric and the channel survey in one month, and
    TEC-NATKIT-37 will add to it again.
    ⚠️ nvs and phy_init are byte-identical to the stock table on purp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
    [partitions.csv]
2026-08-17 Publish the leaf's own view of the link, and put the bench radio config in git
    TEC-NATKIT-37. Two things that made the per-node discrepancy undiagnosable.
    THE LEAF'S HALF OF THE RECIPROCITY CHECK WAS COMPUTED AND THROWN AWAY. LinkStats
    has always held how loudly a leaf hears the hub and what transmit power it ended
    up on; neither ever left the node, so the only published view of a link was the
    primary's. The code's own comment says why that matters -- a bad antenna
    attenuates both directions, a receiver fault shows on one side only, and a frame
    count cannot tell those apart -- and that comparison has found three RF faults on
    this bench while being made from one number.
    Both travel in bytes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
2026-08-18 README: flash by serial/by-id, and two more leaves on the bench
    A port aims at a port, not a board. esptool refuses a chip-type mismatch so aiming a
    leaf image at the S3 fails loudly, but two ESP32 leaves can be flashed in the wrong
    order with no error at all, which silently invalidates any A/B between them.
    Also records the two ESP32s added 2026-08-18 on ttyACM3/ttyACM4, with nothing flashed
    and MACs unknown.
2026-08-18 README: the board condemned as damaged is back, and streaming
    0c:8b:95:96:b9:f4 was removed 2026-08-14 as physically banged up and TEC-NATKIT-46
    closed on it. Reconnected 2026-08-18 it streams at ~10 frames/s and the hub hears it
    at -36 dBm, the loudest of four nodes.
    The original diagnosis was unsafe rather than wrong: the evidence that condemned it
    is what the two undamaged boards have since been doing to each other, alternating
    every 10-30 minutes with nothing touched. Also records the two new leaves and that
    their port mapping is not yet determined.
2026-08-18 Fix the clock fit's residual: the same underflow, in the one loop that was missed (TEC-NATKIT-47)
    ⚠️ THE ROOT CAUSE IS NOT WHAT THE TICKET SAYS, and the difference matters: no
    window was ever latching onto a bad sample, and the fits have been GOOD the whole
    time. `refit()` computed the signed difference `local_us - x0` in three places
    and the `int64_t` cast was missing from exactly one of them -- the residual loop:
    const double x = static_cast<double>(sWindow[i].local_us - x0); // no cast
    sum_x += static_cast<double>(static_cast<int64_t>(...)); // cast
    This is the SAME defect the big comment above it describes and was written to
    warn about. It was fixed in the sums a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
    [espnow_link.hpp, time_sync.cpp, time_sync.hpp]
2026-08-18 Let a build take several profiles, and add ch10 for the channel test (TEC-NATKIT-50)
    The channel is the cheapest decisive test left on TEC-NATKIT-50: the evidence
    says a shared external impairment near channel 3, so moving off it is both the
    experiment and possibly the fix.
    ⚠️ It could not be expressed with the profile mechanism as it stood. A channel
    must be identical at BOTH ends or there is no link, and profiles/bench.defaults
    is explicitly leaves-only -- it pins transmit power, which is measurably harmful
    on the hub. One profile per build meant either a second copy of the power
    settings that can drift from the first, or editing sdkconfig.defaults and
    changing the product default to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
2026-08-18 Publish a noise floor and the hub's die temperature (TEC-NATKIT-50, -51)
    Every instrument this rig had describes the strength of a WANTED signal, and all of
    them read healthy through the 2026-08-18 event in which four leaves lost up to 65% of
    the hub's beacons with RSSI flat to within 2 dB. Signal strength cannot see the floor
    it competes with, so nothing here could tell "the link is fine" from "the link is
    being buried".
    THE FLOOR COMES FROM THE PHY, on packets we were receiving anyway.
    rx_ctrl->noise_floor sits beside the rssi this code already reads, in both receive
    paths -- so it costs no promiscuous mode, no scan and no airtime. It is ENERGY rather
    than decoded frames, which is the har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
    [espnow_link.cpp, espnow_link.hpp, leaf.cpp, primary.cpp, uplink.hpp]
2026-08-19 Poll SNTP every 60 s instead of every hour (TEC-NATKIT-48)
    The hub's wall clock wandered ~38 ms against the site's NTP, and because
    rewriteFrameTimestamps stamps every sample from it, the whole rig inherited the
    wander -- invisible to every coherence figure, which measure node against node
    while the nodes all move together.
    MEASURED FIRST, four consecutive 300 s windows, offset = arrival at the broker
    minus the frame's last sample time:
    +5.9 -> -4.1 -> -14.3 -> -24.9 -> -34.4 ms
    drift -10.0, -10.5, -9.7, -9.5 ms per 300 s
    Dead linear: -119 ms/hour, -33.1 ppm. Not noise and not a bad server -- a
    free-running crystal. CONFIG_LWIP_SNTP_UPDATE_DELAY defaults to ONE HOUR, so the
    clock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
    [gateway_net.cpp]
2026-08-24 TEC-NATKIT-75: the uplink's producer counters lose increments to a race
    frames_queued read ~30 BELOW frames_sent on the live rig while frames_dropped was
    0, which the code makes impossible: every send is preceded by a queue increment.
    The cause is that `uplinkSend()` is called from TWO tasks — the ESP-NOW receive
    callback on the WiFi task, and the 1 Hz status loop — and a plain `++` on a shared
    word loses increments to the interleaving.
    The four producer-side counters (frames_queued, frames_dropped,
    oversize_rejected, queue_high_water) are now std::atomic with relaxed ordering:
    they are counters, nothing synchronises THROUGH them, and only the arithmetic has
    to be sound. queue_high_wate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
2026-08-24 TEC-NATKIT-52: publish the probe's raw sums, so coherence can be windowed
    The rig's only independent measurement of clock agreement could only be read as an
    average since the primary booted. `coherence_typical_us` and the per-leaf
    `residual_rms_ns` are computed in here, from running sums nothing outside can
    difference, so two readings a day apart differ mostly because more history
    accumulated rather than because the rig changed. That makes them useless for the
    one thing they keep being needed for: comparing two conditions.
    So the accumulators go on the wire alongside the derived figures. Per leaf, in
    UplinkNodeStatus: probe_error_sum_us, probe_error_sum_sq, probe_error_count.
    Rig-wide, in U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
2026-08-24 An indicator LED the operator sets, over EXECUTION_COMMAND
    Four leaves on a bench are physically indistinguishable. Their device ids differ by
    two digits in the middle, they are only readable over a console — which on the
    primary RESETS the board when opened — and every diagnosis that starts "which one
    is 0644?" starts by unplugging things.
    `get_led` and `set_led` on the existing command channel, so the operator chooses
    the colour rather than the firmware. A colour baked into the firmware means a table
    in two places, one in code and one in somebody's head, that disagree the first time
    a board is swapped; the frontend already knows every device and can show the
    mapping it set. (An earlie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
    [board_config.hpp, commands.cpp, main.cpp, status_led.cpp, status_led.hpp]
2026-08-24 Fix the ticket reference on the LED work: it is TEC-NATKIT-83
    TEC-NATKIT-82 is the bridge bug that finding it turned up. I wrote the two the
    wrong way round in the comments; the commit messages carry the same error and are
    left alone rather than force-pushed.
    [commands.cpp]
2026-08-24 TEC-NATKIT-84: an inconclusive power sweep must not assert the floor
    `sweepTxPower()` initialised `best` to kLevels[0] -- 2.0 dBm, the floor -- and only
    replaced it when a level beat the previous best percentage. A sweep in which every
    level measures 0% therefore left `best` at the floor and then LATCHED it, because
    `tx_power_swept` was set unconditionally and nothing ever cleared it. The worst
    possible outcome, dressed as a decision.
    The failure is silent and total: rx keeps working, so the leaf goes on hearing
    beacons, reports a locked clock and a strong primary, and cannot deliver a frame.
    Nothing on the device says otherwise.
    Two changes:
    * a sweep that acked nothing at any level ha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
    [espnow_link.cpp]
2026-08-24 TEC-NATKIT-84: put the link fault on the board's own LED
    The antennas are soldered to the PCBs, so "which of these boards is the problem"
    cannot be answered by reseating anything -- and the panel, which knows perfectly
    well that no leaf is delivering, cannot point at a board on a bench. The only
    useful place for that answer is on the board itself.
    A leaf is the right end to say it, because it is the only one that knows BOTH
    whether it hears the hub and whether the hub answers:
    red no primary heard at all -- off, out of range, or another channel
    amber hears the primary, is not acknowledged BY it
    none delivering; shows whatever colour the operator set
    ⚠️ AMBER, NOT RED, for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
    [leaf.cpp, status_led.cpp, status_led.hpp]
2026-08-24 Back off between inconclusive sweeps, and actually restore the power
    ⚠️ MY PREVIOUS COMMIT MADE THE BOARDS RUN HOT, and Zach felt it before any
    instrument showed it.
    Two defects in that fix, both mine:
    1. The inconclusive path said "leaving the power as it was" and did no such thing.
    It returned WITHOUT calling esp_wifi_set_max_tx_power, so the radio stayed at
    the last level the loop had set -- 19.5 dBm, the maximum. The power in force
    before the sweep is now captured and restored, so the comment and the code
    agree.
    2. It retried immediately. A sweep is ~10 s of continuous transmission climbing to
    full power, so retrying it end to end is not a retry policy, it is a 100%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
    [espnow_link.cpp]
2026-08-24 TEC-NATKIT-84: an operator-set transmit power, and it has to stick
    The automatic sweep chooses a transmit power by measuring, which is right, but
    it leaves nobody able to ask a question. "Does this link carry at 11 dBm?" was
    unanswerable: the only way to change the power was to reboot and hope the sweep
    landed somewhere useful.
    get_tx_power -> "8.50 dBm (34 quarter-dBm), chosen by the sweep"
    set_tx_power {"dbm":11} | {"quarter_dbm":44} | {"auto":true}
    ⚠️ PINNING IS THE POINT, not an implementation detail. The sweep re-runs whenever
    sends start failing, and the board this was written for is one whose sends fail at
    every power -- so a hand-set level the sweep may overwrite is a lev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
    [commands.cpp, espnow_link.cpp, espnow_link.hpp]
2026-08-24 TEC-NATKIT-37: pin the transmit power in the defaults, not in a local sdkconfig
    TEC-NATKIT-37 closed with "do not build this" and recorded the bench as both
    leaves pinned at 8.5 dBm with NATKIT_TX_POWER_SWEEP off, plus a warning: if the
    sweep is re-enabled, watch for it choosing very different powers per node,
    because that is what produced the asymmetry the ticket was filed about.
    The warning came true. NATKIT_TX_POWER_SWEEP defaults to y in Kconfig and
    sdkconfig.defaults said nothing, so the known-good state lived only in a local
    sdkconfig -- and a regenerated one silently turned the sweep back on. Measured
    today: three leaves at 2.0, 8.5 and 19.5 dBm, 17 dB apart.
    ⚠️ The symptom is w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
2026-08-25 TEC-NATKIT-34: make the esp32c3 target compile again
    board_config.hpp pinned the BNO08x to GPIO_NUM_32/14/15 unconditionally, and
    the C3 has only GPIO 0-21. Every source is compiled into every image by design,
    so that one header took the WHOLE TARGET down from b42d763 (2026-08-13) until
    now -- without anyone ever selecting a C3 role. "All six images build" has been
    false in the README and in the epic's notes for five slices.
    The ticket declined to fix this for two reasons and neither holds:
    * "the honest fix needs a C3's actual sensor wiring" -- it does not, because
    the C3 is never a leaf. It is the WiFi gateway of the two-board rig, and a
    gateway carries no BNO08x. So the honest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
    [board_config.hpp]
2026-08-25 TEC-NATKIT-87: uplink pin defaults for the C3, and the S3 off the LED's pin
    Two Kconfig defaults, both of which fail invisibly: a boot loop in one case,
    two drivers on one pin in the other.
    The C3 had no uplink pin defaults at all, so it took the classic ESP32's 26/25
    -- numbers a chip with GPIO 0-21 does not have. uart_set_pin then aborts and
    the board reboots in a loop before there is any console output to say why. This
    is the same failure the S3 defaults were added to prevent; the C3 was simply
    never added. It gets 5/6: 11-17 are SPI flash, 18/19 the native USB
    Serial/JTAG, 20/21 the UART0 console, 2/8/9 strapping, 4 the status LED, and
    0/1 are XTAL_32K where a crystal is fitted -- leavi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
2026-08-25 TEC-NATKIT-88: the gateway republishes the status frames it was discarding
    A two-board WiFi rig streamed IMU data perfectly and published nothing at all
    about itself. Confirmed on hardware: four Data topics on the broker and ZERO
    Log- topics, while the gateway's own serial counters showed 972 node-status and
    243 primary-status frames arriving and being dropped on the floor.
    onFrame consumed kNodeStatus for the clock fit and kPrimaryStatus for the
    primary->wall offset, used both, and returned without republishing either. Only
    kData and kCommandLog ever reached gatewayPublish. Everything that reads those
    two topics -- the device-health pill and Logs page (TEC-NATKIT-33), the sealed
    recording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
    [gateway.cpp, uplink.cpp, uplink.hpp]
2026-08-25 TEC-NATKIT-92: device commands reach a node behind a gateway
    Every device button in the frontend was dead on a WiFi rig, silently.
    commandRelayStart() worked by subscribing over MQTT, and behind a gateway the
    primary has no network at all -- so nothing subscribed, the backend published
    into the void, and the frontend waited for an answer that could not come. No
    error at any hop. That killed the indicator LED, calibration and the runtime
    report toggles for every node behind a gateway.
    TEC-NATKIT-26 named this as its one deliberate omission. This is that cost paid.
    The wire was already right for it: full duplex, with the primary's RX pin
    claimed at design time for exactly this and never read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
    [command_relay.cpp, command_relay.hpp, gateway.cpp, primary.cpp, uplink.cpp, uplink.hpp, uplink_reader.cpp, uplink_reader.hpp]
2026-08-25 README: record the WiFi rig, and four boards the table had never heard of
    The table said "update this table when you flash something" and had not been
    updated across two flashings and three new boards. It is the file that stops a
    misflash, so a stale one is worse than none.
    Added: the ESP32-D0WD-V3 hub and the ESP32-C3 gateway (both flashed 2026-08-25),
    a new PICO-V3-02 leaf, and a board that is dead. Every row now carries the
    device id as well as the MAC, because the id is what appears in every topic name
    and the MAC is what esptool prints -- having to convert between them by hand is
    how the wrong board gets flashed.
    Marked the S3 as powered down: two hubs on one ESP-NOW channel adopt eac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
2026-08-25 TEC-NATKIT-93: the gateway reports its own health to the broker
    Every other device in the rig reported itself -- leaves publish
    NatKitNodeStatusV1, the hub NatKitPrimaryStatusV1, and since TEC-NATKIT-88 the
    gateway republishes both faithfully. The gateway said nothing about itself, to
    anyone not holding a serial cable.
    That is the hop that can fail INVISIBLY from the server's side. When this
    gateway's WiFi decayed to -91 dBm the entire rig stopped publishing data, and
    the only reason it was diagnosable is that somebody was attached to the C3. A
    fielded rig has nobody at the bench.
    Now a JSON record every 5 s on Log-<gateway id>-Json-NatLogV1 -- the free-form
    log topic the Logs page already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
    [gateway.cpp]
2026-08-25 TEC-NATKIT-86: count the frame that was too big for the shift buffer
    The primary's self-publish guard chain had no final else, so a payload larger
    than kMaxPayload fell off the end: discarded with no counter and no log line.
    Every other way a frame can fail to reach the uplink queue is counted and
    printed in the NOT PUBLISHED line -- so this one presented as frames the hub
    said it received and the broker never saw, with nothing anywhere to explain the
    gap. That is the shape of failure that costs the most time, and NOT PUBLISHED is
    precisely the instrument used to rule the publish path in or out while chasing
    one.
    ⚠️ Fixed in BOTH places or not at all. Adding the branch to the guard c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
    [espnow_link.cpp, espnow_link.hpp, primary.cpp]
2026-08-25 TEC-NATKIT-81: the hub notices, and says, when a leaf goes quiet
    Leaf 0c:8b:95:96:b9:f4 stopped talking to the hub and the hub did not
    notice. Every counter for it froze -- 987,078 data frames, 49,286
    heartbeats, 96,616 beacons seen, all unchanged over 15 s -- while the hub
    went on composing a status frame for it once a second out of the state it
    had when it left, and `nodes_known` went on saying 4. Nothing published,
    and nothing on the console, distinguished a working rig from a rig with a
    dead board on it.
    ⚠️ The fix is NOT to age the node out, though that is what "the hub never
    expires it" sounds like it asks for. Two things break if it does. The
    roster is exactly what a seal freezes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
    [primary.cpp, uplink.hpp]
2026-08-26 TEC-NATKIT-99: an `identify` command that flashes the board's LED
    "Which board on the bench is this stream?" is the question that has cost the
    most time on this rig, and set_led only answers it once somebody has already
    worked out the mapping and assigned colours. identify answers it for a rig
    nobody has labelled yet, which is every rig the first time.
    ⚠️ FLASHING IS SAFE HERE, despite status_led.hpp's own warning that a blinking
    light was what the design avoided. That warning is about the ARDUINO
    firmware's Adafruit_NeoPixel::show(), which re-installed the ESP32 RMT driver
    on every call and rebooted the board after ~11. This file drives the
    led_strip component: the RMT device is create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
    [commands.cpp, leaf.cpp, status_led.cpp, status_led.hpp]
2026-08-26 TEC-NATKIT-10 slice 3: each leaf advertises what it can be asked to do
    Configuration-<device_id>-Json-NatKitDeviceControlsV1, one per leaf, published
    RETAINED.
    ⚠️ SIXTEEN BYTES ON THE RADIO, NOT A DOCUMENT. espnow_link.hpp is explicit that
    "the leaf never sees JSON" — a leaf is a sensor and a radio, and documents get
    built at the primary, where there is a console and a broker to complain to. So a
    leaf sends a ControlsFrame (device id + capability bitmask) and the primary
    renders it, exactly as it already does for command answers. Shipping ~780 bytes
    of prose per leaf per advertisement would buy nothing: the words are not on the
    device, they are in libnatkit-core's registry.
    ⚠️ TH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
    [device_controls.cpp, device_controls.hpp, espnow_link.cpp, espnow_link.hpp, gateway.cpp, gateway_net.cpp, gateway_net.hpp, leaf.cpp]
2026-08-26 TEC-NATKIT-10 slice 3b: the hub heartbeats only for leaves it has actually heard
    Heartbeat-<leaf_id>-Json-DeviceHeartbeatV1, emitted by the primary alongside
    each 1 Hz status frame, and NEVER retained.
    ⚠️ THIS IS THE PROXY SHAPE THAT PRODUCED TEC-NATKIT-81, and the gate is the
    whole reason it is safe. A leaf cannot publish MQTT, so the hub speaks for it —
    which is exactly what this rig did for 16.8 hours on 2026-08-25/26, republishing
    fresh status frames for four leaves it had not heard while every visible number
    said the rig was complete. A heartbeat emitted on a timer rather than on
    evidence would recreate that fault inside the mechanism built to prevent it.
    So the predicate is TEC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
    [gateway.cpp, primary.cpp, uplink.cpp, uplink.hpp, uplink_reader.cpp, uplink_reader.hpp]
